iSANDEx/pydroponia/README.md

# Pydroponia
Pydroponia is a python-based software to measure water quality variables. It is based on the original ideas of the Food Computer @MIT

Check the [project website](https://isandex.github.io/pydroponia/) for details on how to use this repository
