iSANDEx/pydroponia/docs/source/uso_basico.rst

.. include:: global.rst

Funcionamiento Basico del Software Pydroponia
*********************************************
.. _pydro_sw_flow:
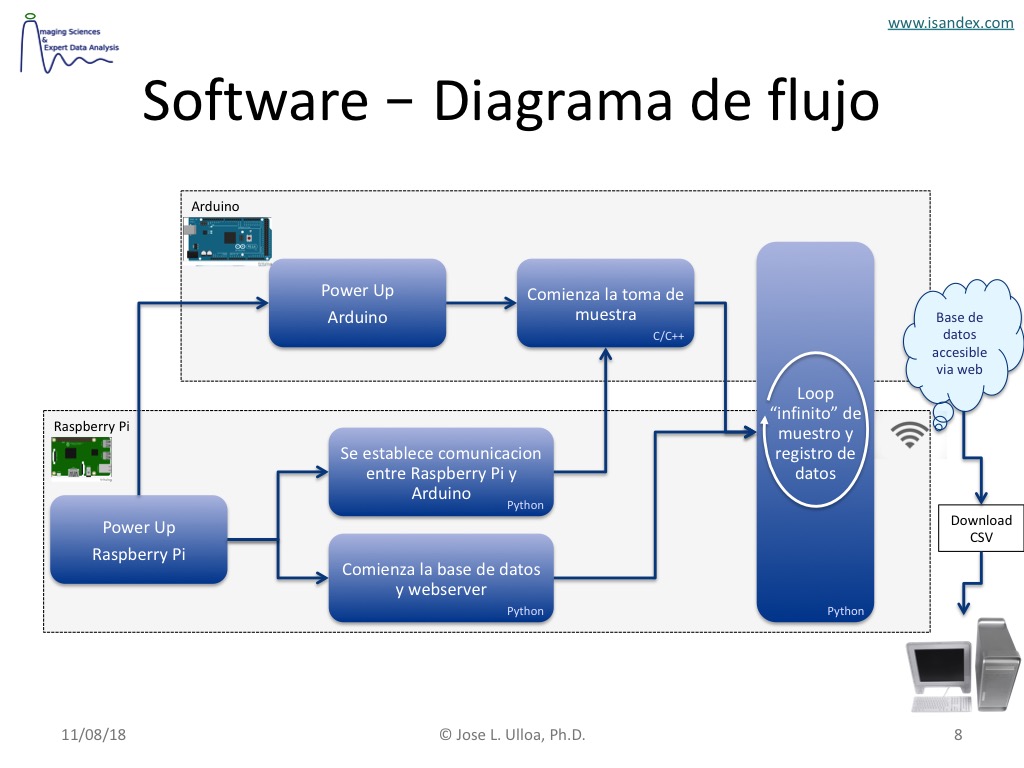
[picture p2: docs/source/_imgs/pydroponia_sw_flow.jpg]


   Diagrama de bloques componentes del software |pydroponia|

Comandos basicos de operacion
=============================

Instalacion desde repositorio
-----------------------------------

.. code-block:: console

   cd ${HOME}
   git clone https://jlulloa@bitbucket.org/jlulloa/pydroponia.git
   cd pydroponia
   ./setup.sh
   sudo reboot

Actualizacion del codigo fuente
-----------------------------------
.. code-block:: console

   cd ${HOME}/pydroponia
   git pull
   ./setup.sh
   sudo reboot

Inicio manual del *data logger*
-----------------------------------
.. code-block:: console

   cd ${HOME}/bin/bioagro
   ./start.sh

Inicio manual del servidor web
-----------------------------------
.. code-block:: console

   cd ${HOME}/bin/bioagro
   ./start_webserver.sh

Ir a: http://pydro001.local

*Work in progres...*
