iSANDEx/pydroponia/docs/source/_imgs/IMG_5827.jpg

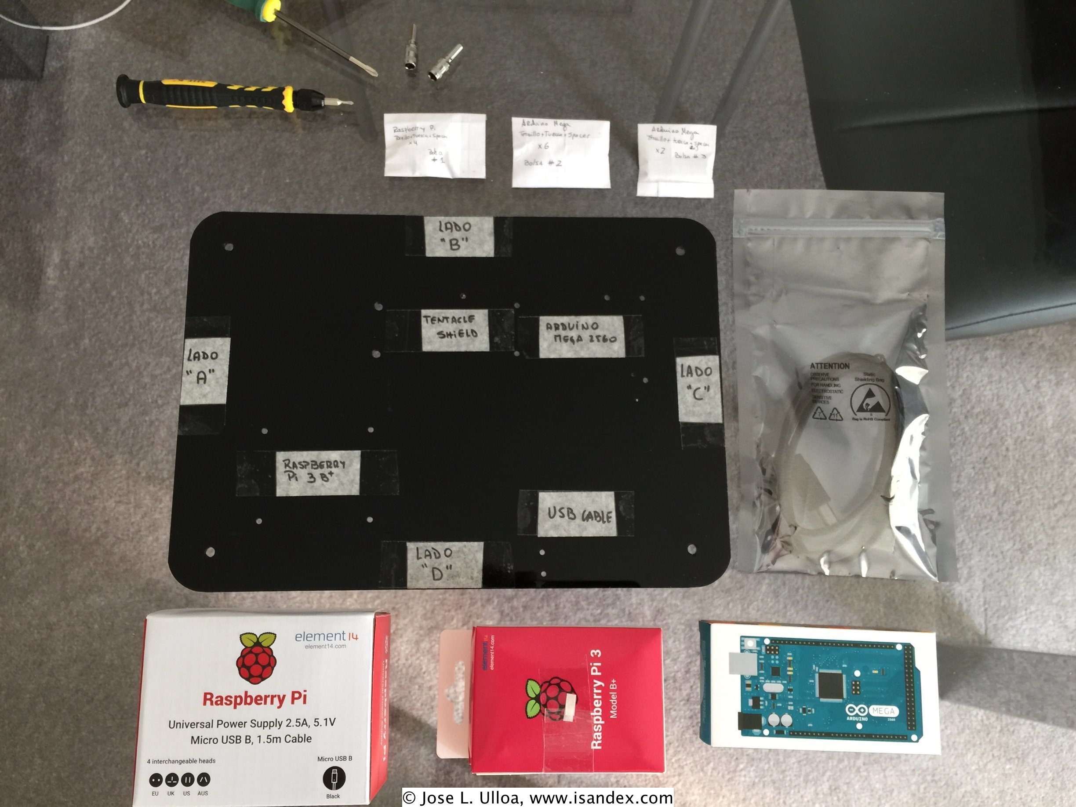
docs/source/_imgs/IMG_5827.jpg
