iSANDEx/pydroponia/docs/source/_imgs/pydroponia_sketch.jpg

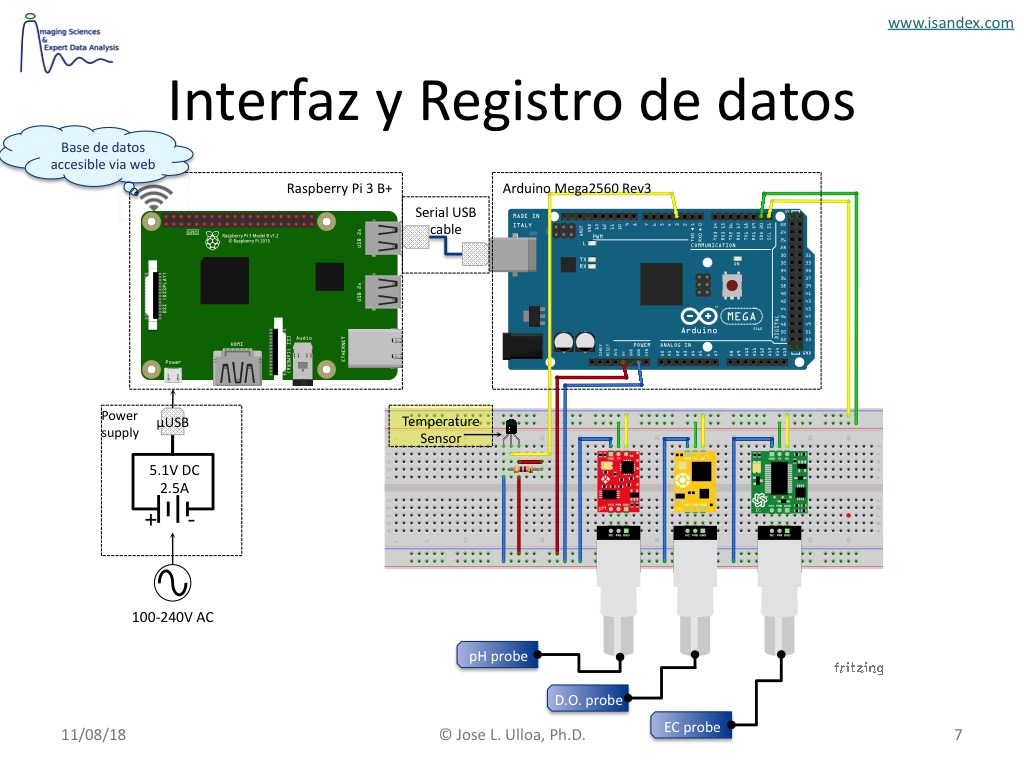
docs/source/_imgs/pydroponia_sketch.jpg
