iSANDEx/pydroponia/arduino/sketches/MoistureSensor/MoistureSensor/MoistureSensor.ino

const int AirValue = 830;   //you need to replace this value with Value_1
const int WaterValue = 434;  //you need to replace this value with Value_2
int soilMoistureValue = 0;
int soilmoisturepercent=0;
void setup() {
  Serial.begin(9600); // open serial port, set the baud rate to 9600 bps
}
void loop() {
soilMoistureValue = analogRead(A0);  //put Sensor insert into soil
Serial.print("Pin Readout: ");
Serial.println(soilMoistureValue);
soilmoisturepercent = map(soilMoistureValue, AirValue, WaterValue, 0, 100);
Serial.print("Actual Readout: ");
Serial.print(soilmoisturepercent);
Serial.println("%");
if(soilmoisturepercent >= 100)
{
  Serial.println("100 %");
}
else if(soilmoisturepercent <=0)
{
  Serial.println("0 %");
}
else if(soilmoisturepercent >0 && soilmoisturepercent < 100)
{
  Serial.print(soilmoisturepercent);
  Serial.println("%");
  
}
  delay(250);
}
