iSANDEx/pydroponia/(commit log)

2024-06-11 Initial Commit - transferred from bitbucket
    [table_01.csv]
2024-06-11 add html instructions - to setup home page
    [configuracion_inicial.rst.txt]
2024-06-11 move documentation to a different branch
    [configuracion_inicial.rst.txt]
